jp112sdl/HB-UNI-Sen-PF-SC/README.md

# HB-UNI-Sen-PF-SC
Universal Sensor for PetFlap

**Aufgabe**</br>
ist es, zu erkennen, ob das Haustier gerade kommt oder geht.</br>
Einerseits als reine Info-Benachrichtigung aufs Handy, andererseits zum Schalten von Aktoren in Abhängigkeit der Anwesenheit des Tieres.

Weiterhin bekomme ich nun auch eine Batterie-Leer-Meldung direkt in der CCU angezeigt, was sonst nur am LCD Display der Tierklappe selbst zu erkennen wäre.

Verbaut ist bei uns eine [SureFlap Haustierklappe](https://www.surepetcare.com/de-de/haustierklappen/mikrochip-haustierklappe) mit RFID (ohne App-Steuerung).</br>
_Den inneren Aufbau der SureFlap Katzenklappe findet man online zum [>>>Download<<<](https://fccid.io/XO9-DOOR-1001/Internal-Photos/Internal-Photos-1909838)._

Da ich weder an der eingebauten Elektronik etwas verändern/abgreifen wollte (um die Funktion nicht zu beeinträchtigen!) noch irgendwelche Kontakte außen anbringen möchte, habe ich mich für den ["magnetic rotary position sensor" AS5600](https://ams.com/documents/20143/36005/AS5600_DS000365_5-00.pdf) entschieden.</br>
Den bekommt man aus Fernost schon für wenig Geld (derzeit knapp 1,80 EUR bei [Aliexpress](https://de.aliexpress.com/item/4000140460377.html)).

**Umsetzung**</br>
war recht einfach.
An einem Ende der Klappenachse ist viel Freiraum. _siehe rotes Rechteck_

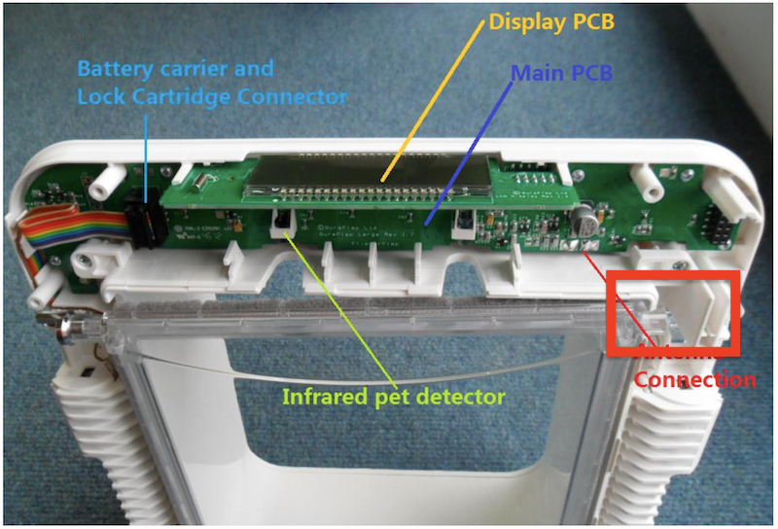
[picture p1: Images/teardown.png]
teardown


Es bot sich an, dort den Sensor zu platzieren.

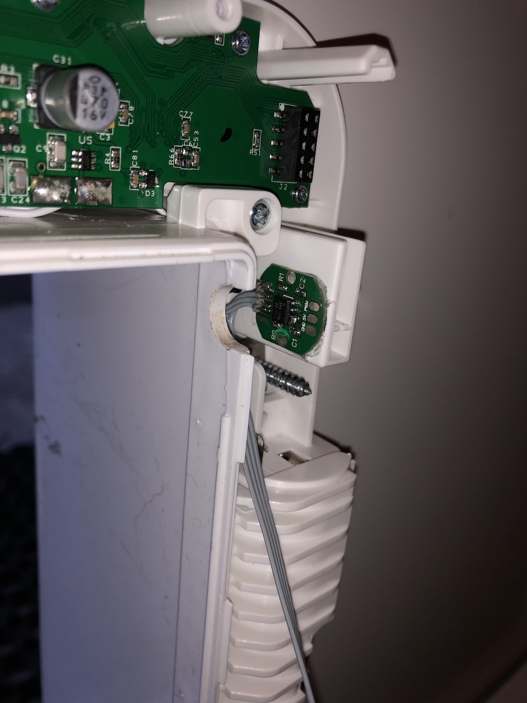
[picture p2: Images/sensor1.jpg]
sensor1


**Wichtig: Der IC muss genau achs-mittig der Klappenachse gegenüberliegen!**

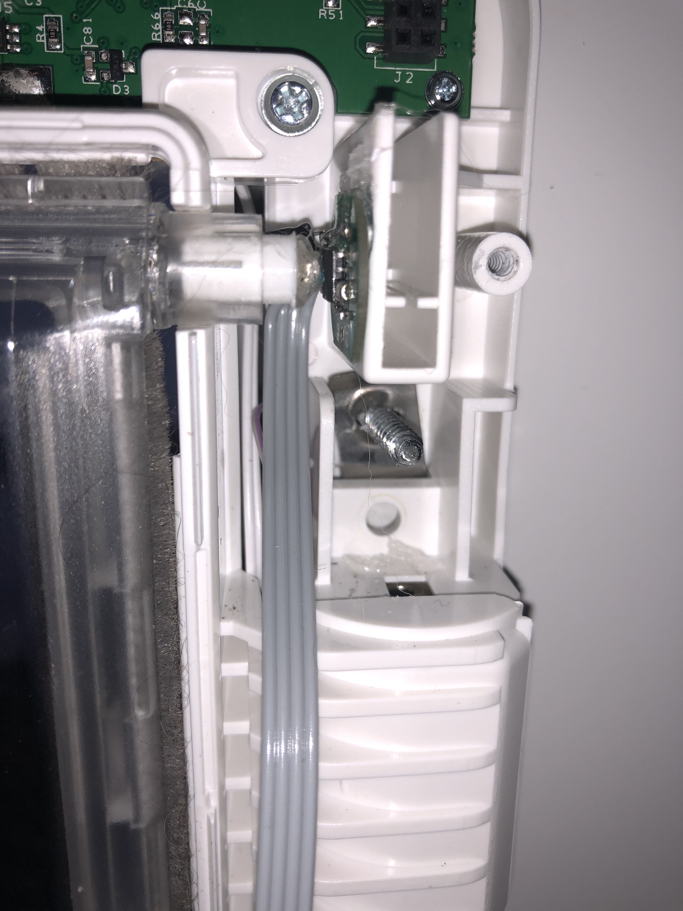
[picture p3: Images/komplett.jpg]
komplett


Für die Magnetaufnahme habe ich einen kleinen Adapter gedruckt. Gut in Heißkleber eingegossen sitzt dort ein [Neodym-Magnet](https://www.magnethandel.de/neodym-magnete-3-2-mm-n52), den ich noch zu liegen hatte.

**Betrieb**</br>

**Einstellungen:**

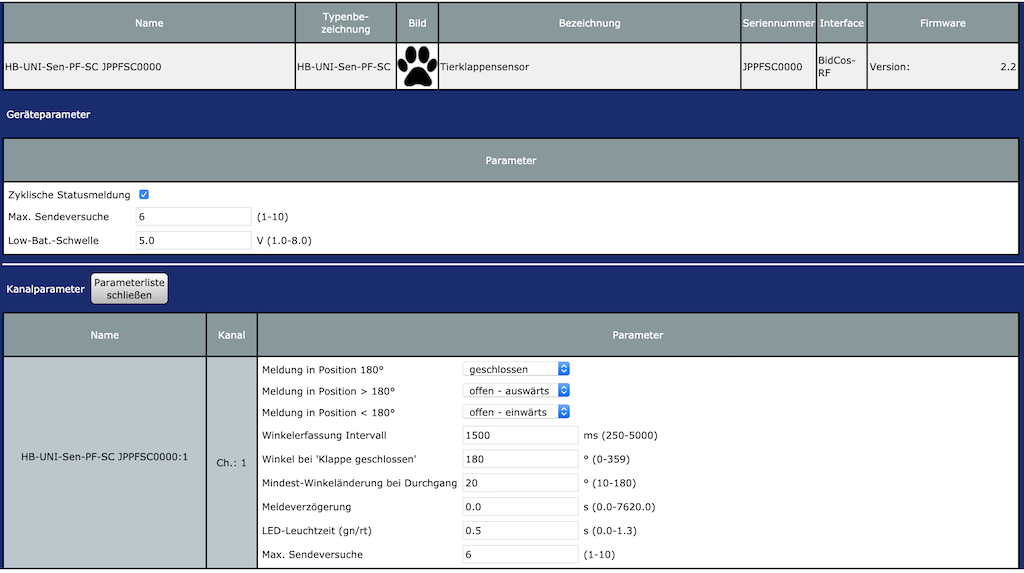
[picture p4: Images/webui_einstellungen.png]
webui_einstellungen


**Ansicht unter "Status und Bedienung"**

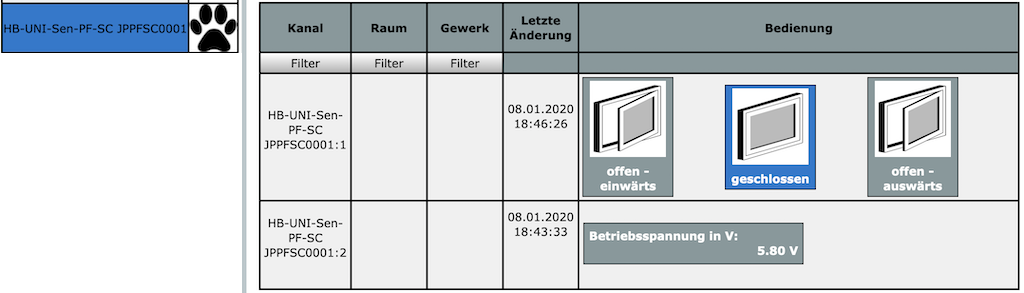
[picture p5: Images/webui_bedienung.png]
webui_bedienung


**Es erfolgt eine kontinuierliche Überwachung des Magnetwinkelsensors. Im Fehlerfall erscheint eine Servicemeldung**

webui_servicemeldung

**Fehlt nur noch das Gehäuse.**

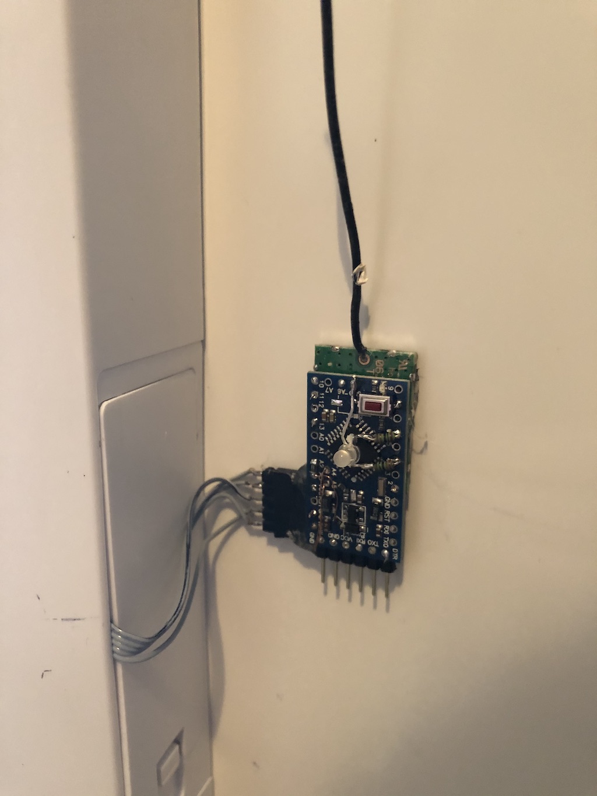
[picture p6: Images/promini.jpg]
promini


**Schaltplan**

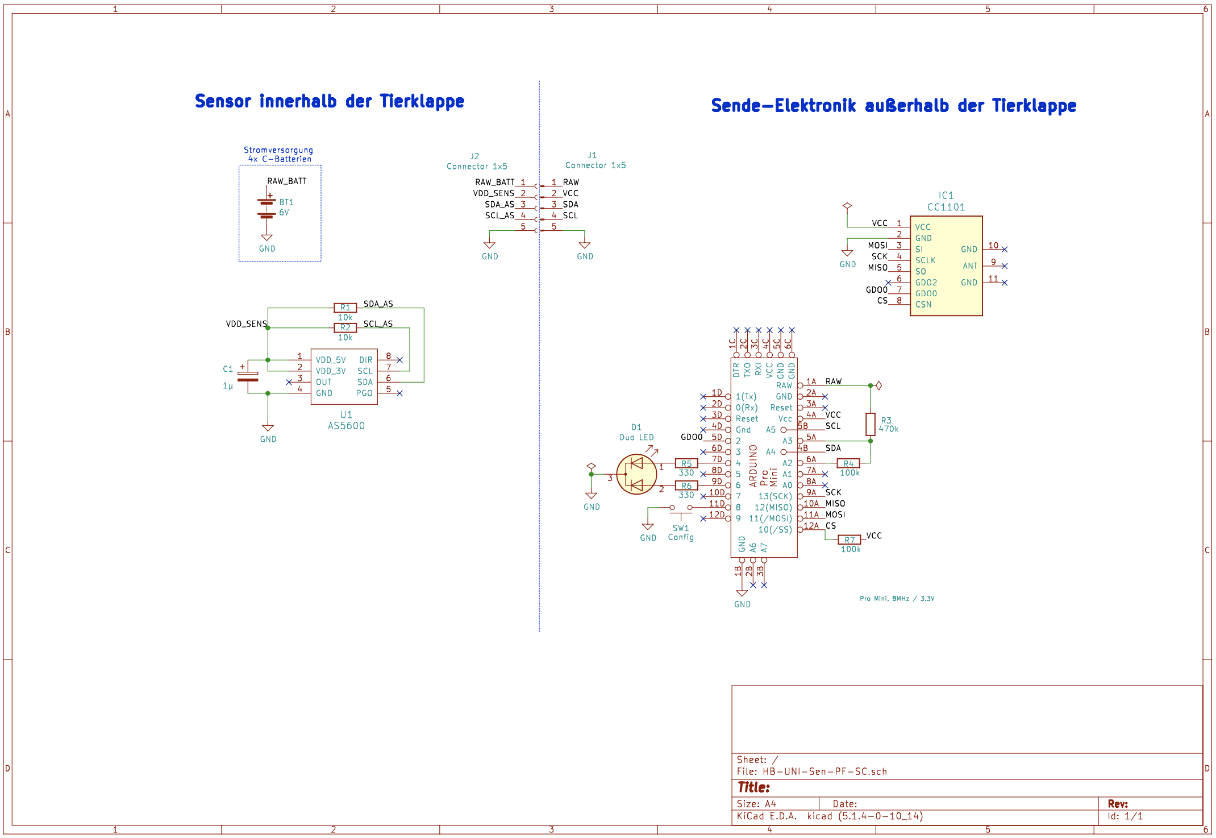
[picture p7: Images/schaltplan.png]


## to be continued
