jp112sdl/HB-UNI-Sen-PF-SC/Images/schaltplan.pdf

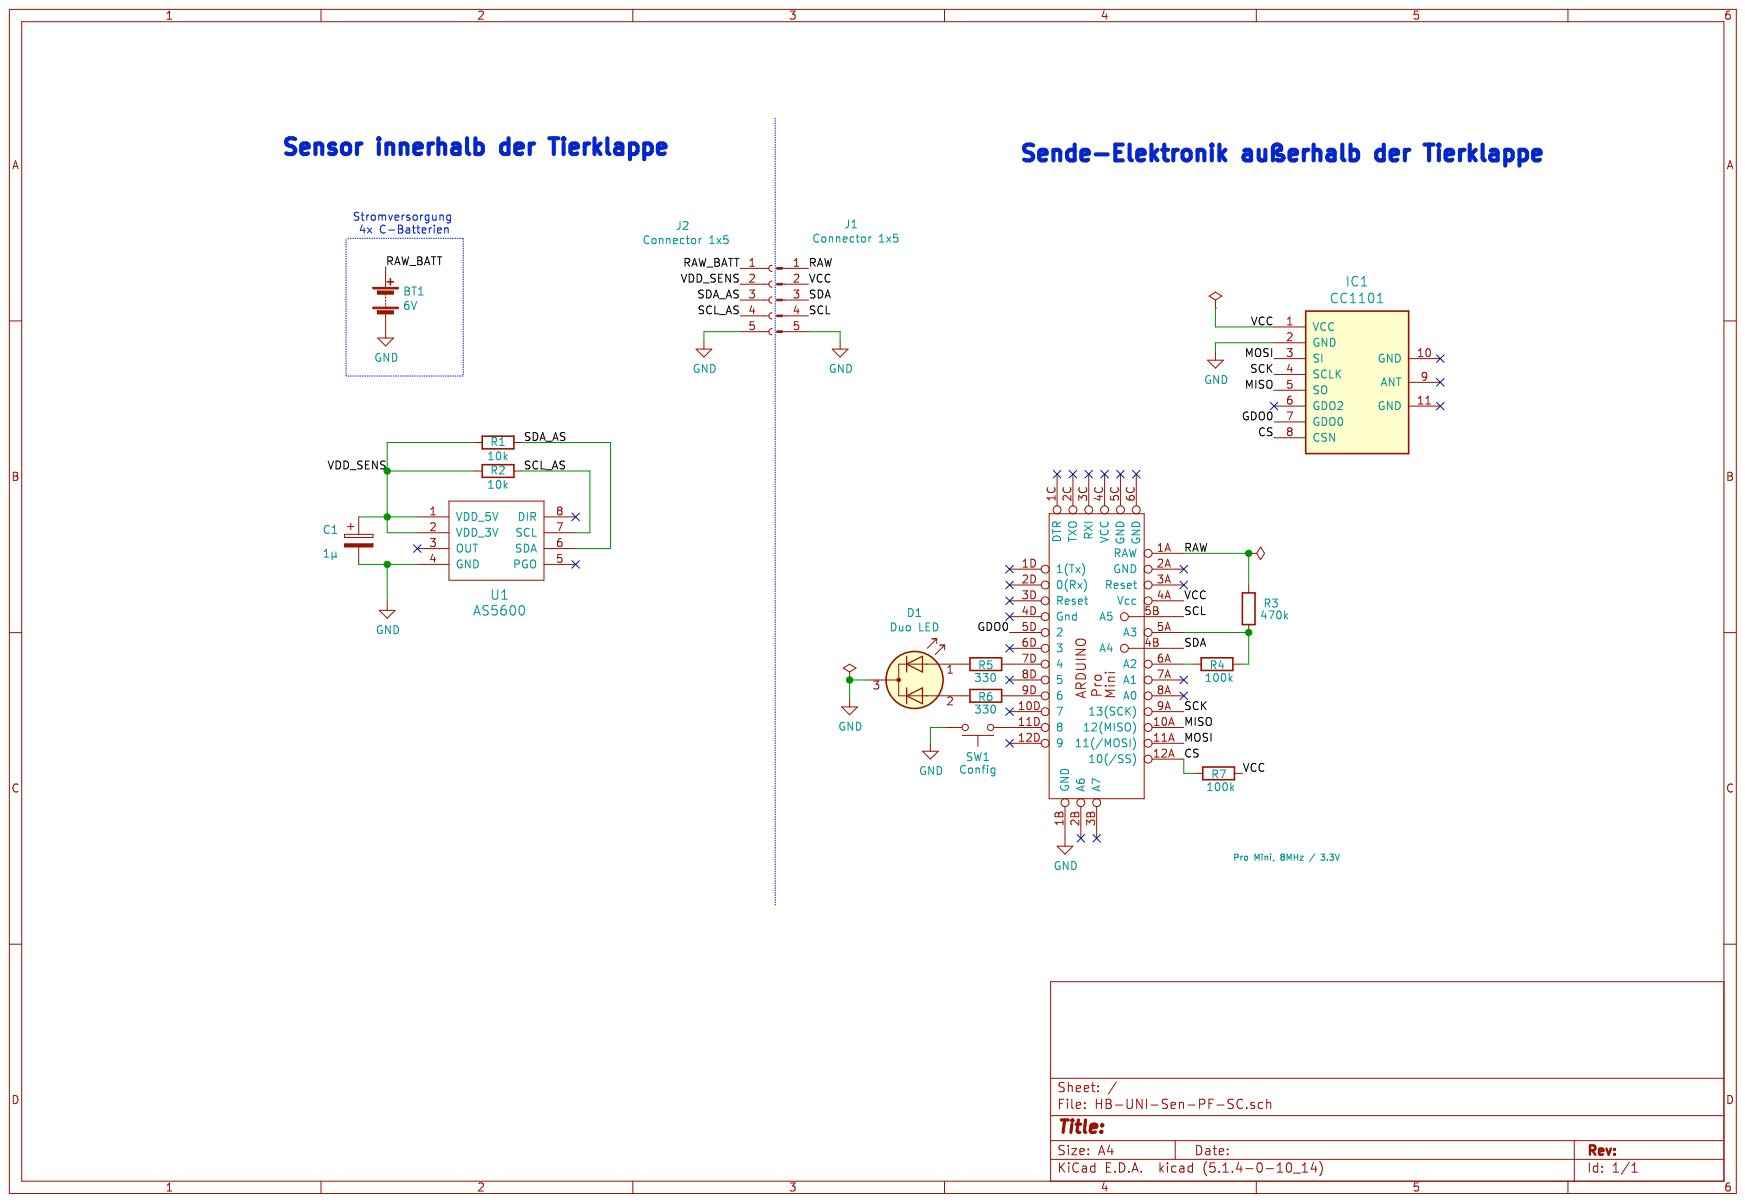
[picture p8: page 1]
