jp112sdl/HB-UNI-Sen-PF-SC/(commit log)

2020-01-05 - moved some settings to webui - add sensor monitoring and error reporting to ccu
    [HB_UNI_Sen_PF_SC.ino]
2020-01-08 moved sensor class to AskSinPP
2020-01-08 add operating voltage channel
2020-01-09 added some additional files
    [HB-UNI-Sen-PF-SC.kicad_pcb, HB-UNI-Sen-PF-SC.sch]
